polyrhythmic-glider/hardware-toolkit/examples-and-tests/esp32-e-lcd/neko-assistant/assets/README.txt

Neko asset partition
====================

The current release draws its monochrome cat and icons procedurally, so the
firmware remains usable even if this SPIFFS partition is erased. Future signed
sound packs and bitmap themes can be staged here without changing the OTA app
partition layout.
