polyrhythmic-glider/hardware-toolkit/examples-and-tests/esp32-e-lcd/NekoAssistant/cat-sprites-preview.png

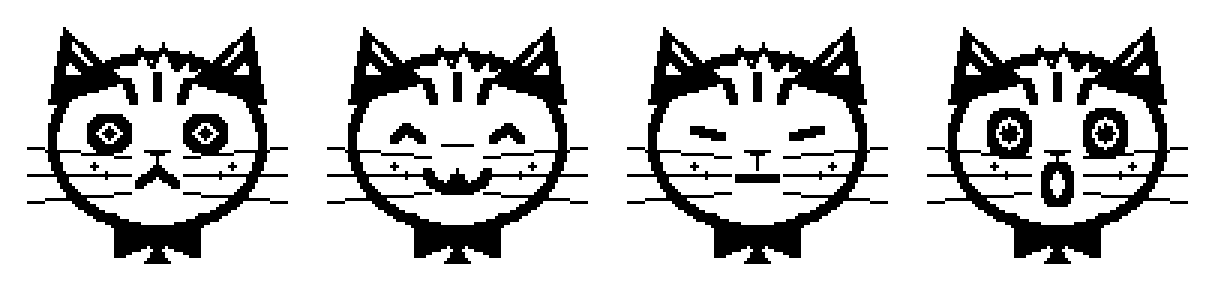
examples-and-tests/esp32-e-lcd/NekoAssistant/cat-sprites-preview.png
