polyrhythmic-glider/hardware-toolkit/TheSynthProject/MenuModel.h

#pragma once

#include <Arduino.h>
#include "ModulationModel.h"

// Azioni disponibili nel menu. Tenerle in un header evita che il preprocessore
// Arduino generi prototipi prima di conoscere il tipo MenuAction.
enum MenuAction {
  ACTION_VOICE_1_MENU,
  ACTION_VOICE_2_MENU,
  ACTION_VOICE_3_MENU,
  ACTION_FILTER_MENU,
  ACTION_OSC_ENABLED,
  ACTION_VOICE_WAVE,
  ACTION_OSC_LEVEL,
  ACTION_OSC_OCTAVE,
  ACTION_VOICE_TUNE,
  ACTION_VOICE_DETUNE,
  ACTION_OSC_PHASE,
  ACTION_OSC_PULSE_WIDTH,
  ACTION_VOICE_FOLD,
  ACTION_OSC_PAN,
  ACTION_OSC_KEY_TRACK,
  ACTION_OSC_MOD_AMOUNT,
  ACTION_VOICE_SCOPE,
  ACTION_PITCH,
  ACTION_LEVEL,
  ACTION_FILTER_POWER,
  ACTION_FILTER_TYPE,
  ACTION_FILTER_CUTOFF,
  ACTION_ADSR,
  ACTION_ATTACK,
  ACTION_DECAY,
  ACTION_SUSTAIN,
  ACTION_RELEASE,
  ACTION_SCOPE,
  ACTION_AUDIO_TEST,
  ACTION_SEQ_START,
  ACTION_SEQ_STOP,
  ACTION_SEQ_BPM,
  ACTION_SEQ_PATTERN_MENU,
  ACTION_SEQ_SETTINGS_MENU,
  ACTION_SEQ_VOICE,
  ACTION_SEQ_STEP,
  ACTION_SEQ_NOTE,
  ACTION_SEQ_LENGTH,
  ACTION_SEQ_PAGE,
  ACTION_SEQ_AUTO_SCROLL,
  ACTION_SEQ_STEP_ENABLE,
  ACTION_MIX_VOICE_1,
  ACTION_MIX_VOICE_2,
  ACTION_MIX_KICK,
  ACTION_KICK_PITCH,
  ACTION_KICK_DECAY,
  ACTION_KICK_SWEEP,
  ACTION_KICK_ATTACK,
  ACTION_KICK_DRIVE,
  ACTION_INPUTS,
  ACTION_DISPLAY_TEST,
  ACTION_SURFACE_MODE,
  ACTION_OLED_DEBUG,
  ACTION_MCP_DEBUG,
  ACTION_NEOKEY_DEBUG,
  ACTION_SERIAL_DEBUG,
  ACTION_CONNECTION_STATUS,
  ACTION_ABOUT,
  ACTION_DELAY_MIX,
  ACTION_DELAY_TIME,
  ACTION_DELAY_FEEDBACK,
  ACTION_REVERB_MIX,
  ACTION_REVERB_ROOM,
  ACTION_PRESET_SLOT,
  ACTION_PRESET_LOAD,
  ACTION_PRESET_SAVE,
  ACTION_SYNTH_VIEW,
  ACTION_TRANSPORT_MENU,
  ACTION_ENV_1_MENU,
  ACTION_ENV_2_MENU,
  ACTION_ENV_3_MENU,
  ACTION_ENV_DESTINATIONS_MENU,
  ACTION_MOD_DESTINATION_MENU,
  ACTION_MOD_ROUTE_ENABLED,
  ACTION_MOD_ROUTE_AMOUNT
};

struct MenuItem {
  const char* tag;
  const char* label;
  MenuAction action;
};

struct AreaChoice {
  const char* tag;
  const char* label;
  const uint8_t* items;
  int itemCount;
};

enum MenuItemIndex {
  ITEM_VOICE_1_MENU,
  ITEM_VOICE_2_MENU,
  ITEM_VOICE_3_MENU,
  ITEM_FILTER_MENU,
  ITEM_OSC_ENABLED,
  ITEM_VOICE_WAVE,
  ITEM_OSC_LEVEL,
  ITEM_OSC_OCTAVE,
  ITEM_VOICE_TUNE,
  ITEM_VOICE_DETUNE,
  ITEM_OSC_PHASE,
  ITEM_OSC_PULSE_WIDTH,
  ITEM_VOICE_FOLD,
  ITEM_OSC_PAN,
  ITEM_OSC_KEY_TRACK,
  ITEM_OSC_MOD_AMOUNT,
  ITEM_VOICE_SCOPE,
  ITEM_PITCH,
  ITEM_LEVEL,
  ITEM_ADSR,
  ITEM_ATTACK,
  ITEM_DECAY,
  ITEM_SCOPE,
  ITEM_INPUTS,
  ITEM_DISPLAY_TEST,
  ITEM_SURFACE_MODE,
  ITEM_OLED_DEBUG,
  ITEM_MCP_DEBUG,
  ITEM_NEOKEY_DEBUG,
  ITEM_SERIAL_DEBUG,
  ITEM_CONNECTION_STATUS,
  ITEM_ABOUT,
  ITEM_AUDIO_TEST,
  ITEM_SEQ_START,
  ITEM_SEQ_STOP,
  ITEM_SEQ_BPM,
  ITEM_SEQ_PATTERN_MENU,
  ITEM_SEQ_SETTINGS_MENU,
  ITEM_SEQ_VOICE,
  ITEM_SEQ_STEP,
  ITEM_SEQ_NOTE,
  ITEM_SEQ_LENGTH,
  ITEM_SEQ_PAGE,
  ITEM_SEQ_AUTO_SCROLL,
  ITEM_SEQ_STEP_ENABLE,
  ITEM_MIX_VOICE_1,
  ITEM_MIX_VOICE_2,
  ITEM_MIX_KICK,
  ITEM_KICK_PITCH,
  ITEM_KICK_DECAY,
  ITEM_KICK_SWEEP,
  ITEM_KICK_ATTACK,
  ITEM_KICK_DRIVE,
  ITEM_SUSTAIN,
  ITEM_RELEASE,
  ITEM_FILTER_POWER,
  ITEM_FILTER_TYPE,
  ITEM_FILTER_CUTOFF,
  ITEM_DELAY_MIX,
  ITEM_DELAY_TIME,
  ITEM_DELAY_FEEDBACK,
  ITEM_REVERB_MIX,
  ITEM_REVERB_ROOM,
  ITEM_PRESET_SLOT,
  ITEM_PRESET_LOAD,
  ITEM_PRESET_SAVE,
  ITEM_SYNTH_VIEW,
  ITEM_TRANSPORT_MENU,
  ITEM_ENV_1_MENU,
  ITEM_ENV_2_MENU,
  ITEM_ENV_3_MENU,
  ITEM_ENV_DESTINATIONS_MENU,
  ITEM_MOD_DEST_AMP_LEVEL,
  ITEM_MOD_DEST_FILTER_CUTOFF,
  ITEM_MOD_DEST_FILTER_RESONANCE,
  ITEM_MOD_DEST_OSC1_PITCH,
  ITEM_MOD_DEST_OSC2_PITCH,
  ITEM_MOD_DEST_OSC3_PITCH,
  ITEM_MOD_DEST_ALL_OSC_PITCH,
  ITEM_MOD_DEST_OSC1_LEVEL,
  ITEM_MOD_DEST_OSC2_LEVEL,
  ITEM_MOD_DEST_OSC3_LEVEL,
  ITEM_MOD_DEST_NOISE_LEVEL,
  ITEM_MOD_DEST_OSC1_PULSE_WIDTH,
  ITEM_MOD_DEST_OSC2_PULSE_WIDTH,
  ITEM_MOD_DEST_OSC3_PULSE_WIDTH,
  ITEM_MOD_DEST_OSC1_WAVEFOLD,
  ITEM_MOD_DEST_OSC2_WAVEFOLD,
  ITEM_MOD_DEST_OSC3_WAVEFOLD,
  ITEM_MOD_DEST_PAN,
  ITEM_MOD_DEST_DELAY_MIX,
  ITEM_MOD_DEST_REVERB_MIX,
  ITEM_MOD_ROUTE_ENABLED,
  ITEM_MOD_ROUTE_AMOUNT
};

enum MenuPage {
  MENU_PAGE_ROOT,
  MENU_PAGE_VOICE_1,
  MENU_PAGE_VOICE_2,
  MENU_PAGE_VOICE_3,
  MENU_PAGE_FILTER,
  MENU_PAGE_TRANSPORT,
  MENU_PAGE_SEQ_PATTERN,
  MENU_PAGE_SEQ_SETTINGS,
  MENU_PAGE_ENV_1,
  MENU_PAGE_ENV_2,
  MENU_PAGE_ENV_3,
  MENU_PAGE_ENV_DESTINATIONS,
  MENU_PAGE_MOD_DESTINATION
};

const MenuItem menuItems[] = {
  { "O1", "Oscillator 1", ACTION_VOICE_1_MENU },
  { "O2", "Oscillator 2", ACTION_VOICE_2_MENU },
  { "O3", "Oscillator 3", ACTION_VOICE_3_MENU },
  { "FLT", "Filter", ACTION_FILTER_MENU },
  { "PWR", "Oscillator Power", ACTION_OSC_ENABLED },
  { "WAVE", "Wave Type", ACTION_VOICE_WAVE },
  { "LEV", "Oscillator Level", ACTION_OSC_LEVEL },
  { "OCT", "Octave", ACTION_OSC_OCTAVE },
  { "TUNE", "Voice Tune", ACTION_VOICE_TUNE },
  { "DET", "Voice Detune", ACTION_VOICE_DETUNE },
  { "PHASE", "Phase Offset", ACTION_OSC_PHASE },
  { "PWM", "Pulse Width", ACTION_OSC_PULSE_WIDTH },
  { "FOLD", "Voice Fold", ACTION_VOICE_FOLD },
  { "PAN", "Oscillator Pan", ACTION_OSC_PAN },
  { "KEY", "Key Tracking", ACTION_OSC_KEY_TRACK },
  { "MOD", "Mod Input", ACTION_OSC_MOD_AMOUNT },
  { "SCP", "Voice Scope", ACTION_VOICE_SCOPE },
  { "TUNE", "Pitch", ACTION_PITCH },
  { "VOL", "Output Volume", ACTION_LEVEL },
  { "ADSR", "ADSR View", ACTION_ADSR },
  { "A", "Attack", ACTION_ATTACK },
  { "D", "Decay", ACTION_DECAY },
  { "SCP", "Wave Scope", ACTION_SCOPE },
  { "IN", "Inputs", ACTION_INPUTS },
  { "LCD", "Display", ACTION_DISPLAY_TEST },
  { "CTRL", "Control Surface", ACTION_SURFACE_MODE },
  { "OLED", "OLED Debug", ACTION_OLED_DEBUG },
  { "MCP", "MCP Debug", ACTION_MCP_DEBUG },
  { "KEY", "NeoKey Debug", ACTION_NEOKEY_DEBUG },
  { "SER", "Serial Diagnostics", ACTION_SERIAL_DEBUG },
  { "LINK", "Connection Status", ACTION_CONNECTION_STATUS },
  { "INFO", "About", ACTION_ABOUT },
  { "AUD", "Test Audio", ACTION_AUDIO_TEST },
  { "PLAY", "Start", ACTION_SEQ_START },
  { "STOP", "Stop", ACTION_SEQ_STOP },
  { "BPM", "Seq BPM", ACTION_SEQ_BPM },
  { "PAT", "Pattern", ACTION_SEQ_PATTERN_MENU },
  { "SET", "Settings", ACTION_SEQ_SETTINGS_MENU },
  { "TRK", "Seq Track", ACTION_SEQ_VOICE },
  { "STEP", "Seq Step", ACTION_SEQ_STEP },
  { "NOTE", "Seq Note", ACTION_SEQ_NOTE },
  { "LEN", "Seq Length", ACTION_SEQ_LENGTH },
  { "PAGE", "Seq Page", ACTION_SEQ_PAGE },
  { "AUTO", "Page Auto Scroll", ACTION_SEQ_AUTO_SCROLL },
  { "ON", "Step On", ACTION_SEQ_STEP_ENABLE },
  { "V1", "Voice 1 Volume", ACTION_MIX_VOICE_1 },
  { "V2", "Voice 2 Volume", ACTION_MIX_VOICE_2 },
  { "KICK", "Kick Level", ACTION_MIX_KICK },
  { "KTUN", "909 Tune", ACTION_KICK_PITCH },
  { "KDEC", "909 Decay", ACTION_KICK_DECAY },
  { "KSWP", "909 Sweep", ACTION_KICK_SWEEP },
  { "KATK", "909 Attack", ACTION_KICK_ATTACK },
  { "KDRV", "909 Drive", ACTION_KICK_DRIVE },
  { "S", "Sustain", ACTION_SUSTAIN },
  { "R", "Release", ACTION_RELEASE },
  { "PWR", "Filter Power", ACTION_FILTER_POWER },
  { "TYPE", "Filter Type", ACTION_FILTER_TYPE },
  { "CUT", "Filter Cutoff", ACTION_FILTER_CUTOFF },
  { "DLY", "Delay Mix", ACTION_DELAY_MIX },
  { "TIME", "Delay Time", ACTION_DELAY_TIME },
  { "FDBK", "Delay Feedback", ACTION_DELAY_FEEDBACK },
  { "REV", "Reverb Mix", ACTION_REVERB_MIX },
  { "ROOM", "Reverb Room", ACTION_REVERB_ROOM },
  { "SLOT", "Preset Slot", ACTION_PRESET_SLOT },
  { "LOAD", "Load Preset", ACTION_PRESET_LOAD },
  { "SAVE", "Save Preset", ACTION_PRESET_SAVE },
  { "VIEW", "Synth View", ACTION_SYNTH_VIEW },
  { "TRNS", "Transport", ACTION_TRANSPORT_MENU },
  { "ENV1", "ENV1", ACTION_ENV_1_MENU },
  { "ENV2", "ENV2", ACTION_ENV_2_MENU },
  { "ENV3", "ENV3", ACTION_ENV_3_MENU },
  { "DEST", "Destinations", ACTION_ENV_DESTINATIONS_MENU },
  { "AMP", "Amp Level", ACTION_MOD_DESTINATION_MENU },
  { "CUT", "Filter Cutoff", ACTION_MOD_DESTINATION_MENU },
  { "RES", "Filter Resonance", ACTION_MOD_DESTINATION_MENU },
  { "O1P", "Oscillator 1 Pitch", ACTION_MOD_DESTINATION_MENU },
  { "O2P", "Oscillator 2 Pitch", ACTION_MOD_DESTINATION_MENU },
  { "O3P", "Oscillator 3 Pitch", ACTION_MOD_DESTINATION_MENU },
  { "ALLP", "All Osc Pitch", ACTION_MOD_DESTINATION_MENU },
  { "O1L", "Oscillator 1 Level", ACTION_MOD_DESTINATION_MENU },
  { "O2L", "Oscillator 2 Level", ACTION_MOD_DESTINATION_MENU },
  { "O3L", "Oscillator 3 Level", ACTION_MOD_DESTINATION_MENU },
  { "NOISE", "Noise Level", ACTION_MOD_DESTINATION_MENU },
  { "O1PW", "Oscillator 1 PWM", ACTION_MOD_DESTINATION_MENU },
  { "O2PW", "Oscillator 2 PWM", ACTION_MOD_DESTINATION_MENU },
  { "O3PW", "Oscillator 3 PWM", ACTION_MOD_DESTINATION_MENU },
  { "O1F", "Oscillator 1 Fold", ACTION_MOD_DESTINATION_MENU },
  { "O2F", "Oscillator 2 Fold", ACTION_MOD_DESTINATION_MENU },
  { "O3F", "Oscillator 3 Fold", ACTION_MOD_DESTINATION_MENU },
  { "PAN", "Pan", ACTION_MOD_DESTINATION_MENU },
  { "DLY", "Delay Mix", ACTION_MOD_DESTINATION_MENU },
  { "REV", "Reverb Mix", ACTION_MOD_DESTINATION_MENU },
  { "ON", "Enabled", ACTION_MOD_ROUTE_ENABLED },
  { "AMT", "Amount", ACTION_MOD_ROUTE_AMOUNT }
};

const int MENU_ITEM_COUNT = sizeof(menuItems) / sizeof(menuItems[0]);
static_assert(MENU_ITEM_COUNT == ITEM_MOD_ROUTE_AMOUNT + 1, "Menu item index mismatch");
static_assert(ITEM_MOD_DEST_REVERB_MIX - ITEM_MOD_DEST_AMP_LEVEL + 1 == MOD_DESTINATION_COUNT,
              "Modulation destination menu mismatch");

// Indici dentro menuItems, separati per area o sottomenu.
const uint8_t MENU_WAVE_ITEMS[] = {
  ITEM_VOICE_1_MENU,
  ITEM_VOICE_2_MENU,
  ITEM_VOICE_3_MENU,
  ITEM_PITCH,
  ITEM_FILTER_MENU
};
const uint8_t MENU_WAVE_VOICE_ITEMS[] = {
  ITEM_OSC_ENABLED,
  ITEM_VOICE_WAVE,
  ITEM_OSC_LEVEL,
  ITEM_OSC_OCTAVE,
  ITEM_VOICE_TUNE,
  ITEM_VOICE_DETUNE,
  ITEM_OSC_PHASE,
  ITEM_OSC_PULSE_WIDTH,
  ITEM_VOICE_FOLD,
  ITEM_OSC_PAN,
  ITEM_OSC_KEY_TRACK,
  ITEM_OSC_MOD_AMOUNT,
  ITEM_VOICE_SCOPE
};
const uint8_t MENU_FILTER_ITEMS[] = {
  ITEM_FILTER_POWER,
  ITEM_FILTER_TYPE,
  ITEM_FILTER_CUTOFF
};
const uint8_t MENU_MIXER_ITEMS[] = {
  ITEM_MIX_VOICE_1,
  ITEM_MIX_VOICE_2,
  ITEM_DELAY_MIX,
  ITEM_DELAY_TIME,
  ITEM_DELAY_FEEDBACK,
  ITEM_REVERB_MIX,
  ITEM_REVERB_ROOM
};
const uint8_t MENU_KICK_ITEMS[] = {
  ITEM_MIX_KICK,
  ITEM_KICK_PITCH,
  ITEM_KICK_ATTACK,
  ITEM_KICK_DECAY,
  ITEM_KICK_SWEEP,
  ITEM_KICK_DRIVE
};
const uint8_t MENU_ENVELOPE_ITEMS[] = {
  ITEM_ENV_1_MENU,
  ITEM_ENV_2_MENU,
  ITEM_ENV_3_MENU
};
const uint8_t MENU_ENV_SOURCE_ITEMS[] = {
  ITEM_ATTACK,
  ITEM_DECAY,
  ITEM_SUSTAIN,
  ITEM_RELEASE,
  ITEM_ENV_DESTINATIONS_MENU
};
const uint8_t MENU_MOD_DESTINATION_ITEMS[] = {
  ITEM_MOD_DEST_AMP_LEVEL,
  ITEM_MOD_DEST_FILTER_CUTOFF,
  ITEM_MOD_DEST_FILTER_RESONANCE,
  ITEM_MOD_DEST_OSC1_PITCH,
  ITEM_MOD_DEST_OSC2_PITCH,
  ITEM_MOD_DEST_OSC3_PITCH,
  ITEM_MOD_DEST_ALL_OSC_PITCH,
  ITEM_MOD_DEST_OSC1_LEVEL,
  ITEM_MOD_DEST_OSC2_LEVEL,
  ITEM_MOD_DEST_OSC3_LEVEL,
  ITEM_MOD_DEST_NOISE_LEVEL,
  ITEM_MOD_DEST_OSC1_PULSE_WIDTH,
  ITEM_MOD_DEST_OSC2_PULSE_WIDTH,
  ITEM_MOD_DEST_OSC3_PULSE_WIDTH,
  ITEM_MOD_DEST_OSC1_WAVEFOLD,
  ITEM_MOD_DEST_OSC2_WAVEFOLD,
  ITEM_MOD_DEST_OSC3_WAVEFOLD,
  ITEM_MOD_DEST_PAN,
  ITEM_MOD_DEST_DELAY_MIX,
  ITEM_MOD_DEST_REVERB_MIX
};
const uint8_t MENU_MOD_ROUTE_ITEMS[] = {
  ITEM_MOD_ROUTE_ENABLED,
  ITEM_MOD_ROUTE_AMOUNT
};
const uint8_t MENU_SEQUENCER_ITEMS[] = {
  ITEM_SYNTH_VIEW,
  ITEM_TRANSPORT_MENU,
  ITEM_SEQ_PATTERN_MENU,
  ITEM_SEQ_SETTINGS_MENU
};
const uint8_t MENU_SEQ_PATTERN_ITEMS[] = {
  ITEM_SEQ_VOICE,
  ITEM_SEQ_STEP,
  ITEM_SEQ_NOTE,
  ITEM_SEQ_STEP_ENABLE
};
const uint8_t MENU_TRANSPORT_ITEMS[] = {
  ITEM_SEQ_START,
  ITEM_SEQ_STOP,
  ITEM_SEQ_BPM
};
const uint8_t MENU_SEQ_SETTINGS_ITEMS[] = {
  ITEM_SEQ_LENGTH,
  ITEM_SEQ_PAGE,
  ITEM_SEQ_AUTO_SCROLL
};
const uint8_t MENU_UTILITY_ITEMS[] = {
  ITEM_INPUTS,
  ITEM_DISPLAY_TEST,
  ITEM_SURFACE_MODE,
  ITEM_OLED_DEBUG,
  ITEM_MCP_DEBUG,
  ITEM_NEOKEY_DEBUG,
  ITEM_SERIAL_DEBUG,
  ITEM_CONNECTION_STATUS,
  ITEM_LEVEL,
  ITEM_AUDIO_TEST,
  ITEM_ABOUT,
  ITEM_PRESET_SLOT,
  ITEM_PRESET_LOAD,
  ITEM_PRESET_SAVE
};
const AreaChoice areaChoices[] = {
  { "WAVE", "Wave Engine", MENU_WAVE_ITEMS, sizeof(MENU_WAVE_ITEMS) / sizeof(MENU_WAVE_ITEMS[0]) },
  { "MIX", "Mixer", MENU_MIXER_ITEMS, sizeof(MENU_MIXER_ITEMS) / sizeof(MENU_MIXER_ITEMS[0]) },
  { "KICK", "Kick Voice", MENU_KICK_ITEMS, sizeof(MENU_KICK_ITEMS) / sizeof(MENU_KICK_ITEMS[0]) },
  { "ENV", "Envelope", MENU_ENVELOPE_ITEMS, sizeof(MENU_ENVELOPE_ITEMS) / sizeof(MENU_ENVELOPE_ITEMS[0]) },
  { "SEQ", "Sequencer", MENU_SEQUENCER_ITEMS, sizeof(MENU_SEQUENCER_ITEMS) / sizeof(MENU_SEQUENCER_ITEMS[0]) },
  { "UTIL", "Utility", MENU_UTILITY_ITEMS, sizeof(MENU_UTILITY_ITEMS) / sizeof(MENU_UTILITY_ITEMS[0]) }
};

const int TYPE_COUNT = sizeof(areaChoices) / sizeof(areaChoices[0]);
const int SEQUENCER_AREA_INDEX = 4;
