polyrhythmic-glider/hardware-toolkit/TheSynthProject/MixerModel.h

#pragma once

#include "MenuModel.h"

// Converte un'azione mixer nell'indice della voce corrispondente.
inline int getMixerWaveIndex(int action) {
  switch (action) {
    case ACTION_MIX_VOICE_1:
      return 0;

    case ACTION_MIX_VOICE_2:
      return 1;

    default:
      return -1;
  }
}

// Checksum compatto per invalidare la UI quando cambia un gruppo di fader.
inline int getLevelChecksum(const int levels[], int count) {
  int checksum = 0;

  for (int i = 0; i < count; i++) {
    checksum = checksum * 31 + levels[i];
  }

  return checksum;
}
