polyrhythmic-glider/hardware-toolkit/TheSynthProject/UiWidgets.h

#pragma once

extern uint16_t neokeyLastRawKeys;
extern uint16_t neokeyStableKeys;
extern uint8_t neokeyLastBoardRawKeys[];

uint16_t getSequencerTrackColor(int track);

void drawHeader(const char* title) {
  tft.fillRect(0, 0, SCREEN_W, 20, COL_HEADER);
  tft.fillTriangle(0, 0, 18, 0, 0, 20, COL_VIOLET);
  tft.drawFastHLine(0, 19, SCREEN_W, COL_CORAL);

  tft.setTextSize(1);
  tft.setTextColor(COL_INK);
  tft.setCursor(7, 6);
  tft.print(title);
}

void drawStageBackdrop() {
  tft.fillScreen(COL_BG);

  for (int y = 25; y < SCREEN_H; y += 12) {
    tft.drawFastHLine(0, y, SCREEN_W, COL_LINE);
  }

  for (int i = 0; i < 10; i++) {
    int x = 13 + i * 15;
    int y = 31 + (i * 17) % 72;
    tft.drawPixel(x, y, COL_MUTED);
    tft.drawPixel(x + 1, y, COL_MUTED);
  }
}

void drawParamIcon(int itemIndex, int cx, int cy, uint16_t color) {
  MenuAction action = menuItems[itemIndex].action;

  switch (action) {
    case ACTION_VOICE_1_MENU:
      drawWaveShapePreviewForParams(cx - 8, cy - 5, 16, 10, waveVoiceShape[0], (float)waveVoiceFold[0], 0.0f, color);
      tft.drawPixel(cx + 9, cy, COL_GOLD);
      break;

    case ACTION_VOICE_2_MENU:
      drawWaveShapePreviewForParams(cx - 8, cy - 5, 16, 10, waveVoiceShape[1], (float)waveVoiceFold[1], 0.0f, color);
      tft.drawPixel(cx + 9, cy, COL_GOLD);
      break;

    case ACTION_FILTER_MENU:
      tft.drawFastHLine(cx - 8, cy + 5, 16, rgb565(62, 68, 82));
      tft.drawLine(cx - 8, cy - 5, cx, cy - 1, color);
      tft.drawLine(cx, cy - 1, cx + 8, cy + 5, color);
      tft.drawPixel(cx + 10, cy, COL_GOLD);
      break;

    case ACTION_VOICE_WAVE:
    {
      int voice = getCurrentWaveVoiceIndex();
      drawWaveShapePreviewForParams(cx - 8, cy - 5, 16, 10, waveVoiceShape[voice], (float)waveVoiceFold[voice], 0.0f, color);
      tft.drawPixel(cx + 9, cy, COL_GOLD);
      break;
    }

    case ACTION_VOICE_TUNE:
      tft.drawFastVLine(cx, cy - 7, 15, color);
      tft.drawLine(cx - 6, cy - 5, cx, cy - 1, color);
      tft.drawLine(cx + 6, cy - 5, cx, cy - 1, color);
      tft.fillCircle(cx, cy + 5, 2, COL_GOLD);
      break;

    case ACTION_VOICE_FOLD:
      tft.drawLine(cx - 8, cy + 4, cx - 3, cy - 5, color);
      tft.drawLine(cx - 3, cy - 5, cx + 2, cy + 5, color);
      tft.drawLine(cx + 2, cy + 5, cx + 7, cy - 4, color);
      tft.fillCircle(cx + 8, cy - 4, 1, COL_GOLD);
      break;

    case ACTION_VOICE_DETUNE:
      tft.drawCircle(cx, cy, 6, color);
      tft.drawLine(cx, cy, cx + 6, cy - 1, color);
      tft.fillCircle(cx + 6, cy - 1, 2, COL_GOLD);
      break;

    case ACTION_VOICE_SCOPE:
    {
      int voice = getCurrentWaveVoiceIndex();
      drawWaveShapePreviewForParams(cx - 8, cy - 5, 16, 10, waveVoiceShape[voice], (float)waveVoiceFold[voice], 0.0f, color);
      tft.drawFastHLine(cx - 8, cy + 7, 16, COL_GOLD);
      break;
    }

    case ACTION_PITCH:
      tft.drawFastVLine(cx, cy - 6, 13, color);
      tft.drawLine(cx - 5, cy - 5, cx, cy - 1, color);
      tft.drawLine(cx + 5, cy - 5, cx, cy - 1, color);
      tft.fillCircle(cx, cy + 5, 2, color);
      break;

    case ACTION_LEVEL:
      for (int i = 0; i < 4; i++) {
        int h = 4 + i * 3;
        tft.fillRect(cx - 8 + i * 5, cy + 6 - h, 3, h, color);
      }
      break;

    case ACTION_FILTER_POWER:
      tft.drawCircle(cx, cy, 8, color);
      tft.drawFastVLine(cx, cy - 8, 8, color);
      tft.drawFastHLine(cx - 6, cy + 5, 12, filterEnabled ? COL_GOLD : rgb565(62, 68, 82));
      break;

    case ACTION_FILTER_TYPE:
      tft.drawFastHLine(cx - 8, cy + 5, 16, rgb565(62, 68, 82));
      tft.drawLine(cx - 8, cy - 5, cx - 1, cy - 2, color);
      tft.drawLine(cx - 1, cy - 2, cx + 3, cy + 3, color);
      tft.drawLine(cx + 3, cy + 3, cx + 8, cy + 5, color);
      break;

    case ACTION_FILTER_CUTOFF:
      tft.drawFastHLine(cx - 8, cy + 5, 16, color);
      tft.drawFastVLine(cx, cy - 6, 12, COL_GOLD);
      tft.drawLine(cx - 8, cy - 2, cx, cy - 2, color);
      tft.drawLine(cx, cy - 2, cx + 8, cy + 4, color);
      break;

    case ACTION_ADSR:
    case ACTION_ENV_1_MENU:
    case ACTION_ENV_2_MENU:
      tft.drawLine(cx - 8, cy + 5, cx - 3, cy - 5, color);
      tft.drawLine(cx - 3, cy - 5, cx + 2, cy, color);
      tft.drawLine(cx + 2, cy, cx + 6, cy, color);
      tft.drawLine(cx + 6, cy, cx + 8, cy + 5, color);
      break;

    case ACTION_ENV_DESTINATIONS_MENU:
    case ACTION_MOD_DESTINATION_MENU:
      tft.fillCircle(cx - 7, cy, 2, COL_GOLD);
      tft.fillCircle(cx + 7, cy - 5, 2, color);
      tft.fillCircle(cx + 7, cy + 5, 2, color);
      tft.drawLine(cx - 5, cy, cx + 5, cy - 5, color);
      tft.drawLine(cx - 5, cy, cx + 5, cy + 5, color);
      break;

    case ACTION_MOD_ROUTE_ENABLED:
      tft.drawCircle(cx, cy, 8, color);
      tft.drawFastVLine(cx, cy - 8, 8, COL_GOLD);
      break;

    case ACTION_MOD_ROUTE_AMOUNT:
      tft.drawFastHLine(cx - 8, cy, 17, color);
      tft.drawFastVLine(cx, cy - 7, 15, COL_GOLD);
      tft.fillCircle(cx + 6, cy, 2, color);
      break;

    case ACTION_ATTACK:
      tft.drawLine(cx - 8, cy + 5, cx + 7, cy - 5, color);
      tft.drawFastHLine(cx - 8, cy + 5, 16, color);
      tft.fillTriangle(cx + 7, cy - 5, cx + 3, cy - 4, cx + 5, cy - 1, color);
      break;

    case ACTION_DECAY:
      tft.drawLine(cx - 8, cy - 5, cx + 7, cy + 5, color);
      tft.drawFastHLine(cx - 8, cy + 5, 16, color);
      tft.fillTriangle(cx + 7, cy + 5, cx + 3, cy + 4, cx + 5, cy + 1, color);
      break;

    case ACTION_SUSTAIN:
      tft.drawLine(cx - 8, cy - 4, cx - 2, cy, color);
      tft.drawFastHLine(cx - 2, cy, 10, color);
      tft.drawFastHLine(cx - 8, cy + 5, 16, rgb565(62, 68, 82));
      tft.fillCircle(cx + 7, cy, 2, color);
      break;

    case ACTION_RELEASE:
      tft.drawFastHLine(cx - 8, cy + 5, 16, rgb565(62, 68, 82));
      tft.drawLine(cx - 8, cy - 5, cx + 7, cy + 5, color);
      tft.fillTriangle(cx + 7, cy + 5, cx + 3, cy + 4, cx + 5, cy + 1, color);
      break;

    case ACTION_SCOPE:
      drawWavePreview(cx - 8, cy - 5, 16, 10, color);
      break;

    case ACTION_AUDIO_TEST:
      drawWavePreview(cx - 8, cy - 5, 16, 10, color);
      tft.drawFastVLine(cx + 9, cy - 7, 14, COL_GOLD);
      break;

    case ACTION_TRANSPORT_MENU:
      tft.drawCircle(cx, cy, 9, color);
      tft.fillTriangle(cx - 4, cy - 5, cx - 4, cy + 5, cx + 3, cy, color);
      tft.fillRect(cx + 4, cy - 4, 3, 8, COL_GOLD);
      break;

    case ACTION_SEQ_START:
      tft.fillTriangle(cx - 5, cy - 7, cx - 5, cy + 7, cx + 7, cy, color);
      tft.drawCircle(cx, cy, 9, transportRunning ? COL_GOLD : rgb565(62, 68, 82));
      break;

    case ACTION_SEQ_STOP:
      tft.fillRect(cx - 6, cy - 6, 12, 12, color);
      tft.drawCircle(cx, cy, 9, !transportRunning ? COL_GOLD : rgb565(62, 68, 82));
      break;

    case ACTION_SYNTH_VIEW:
      tft.drawRect(cx - 9, cy - 7, 18, 14, color);
      tft.drawFastHLine(cx - 7, cy + 3, 14, COL_GOLD);
      tft.fillCircle(cx - 4, cy - 1, 2, color);
      tft.fillCircle(cx + 4, cy - 1, 2, COL_SKY);
      break;

    case ACTION_SEQ_PATTERN_MENU:
      for (int row = 0; row < 3; row++) {
        uint16_t laneColor = getSequencerTrackColor(row);
        tft.drawFastHLine(cx - 8, cy - 6 + row * 6, 17, laneColor);
        tft.fillCircle(cx - 4 + row * 4, cy - 6 + row * 6, 2, laneColor);
      }
      break;

    case ACTION_SEQ_SETTINGS_MENU:
      tft.drawCircle(cx, cy, 7, color);
      tft.fillCircle(cx, cy, 2, COL_GOLD);
      tft.drawFastVLine(cx, cy - 10, 4, color);
      tft.drawFastVLine(cx, cy + 7, 4, color);
      tft.drawFastHLine(cx - 10, cy, 4, color);
      tft.drawFastHLine(cx + 7, cy, 4, color);
      break;

    case ACTION_SEQ_BPM:
      tft.drawCircle(cx, cy, 8, color);
      tft.drawLine(cx, cy, cx + 5, cy - 5, color);
      tft.fillCircle(cx, cy, 2, COL_GOLD);
      break;

    case ACTION_SEQ_VOICE:
      tft.drawRect(cx - 8, cy - 6, 16, 12, color);
      tft.drawFastHLine(cx - 8, cy, 16, COL_LINE);
      tft.fillRect(cx - 6, cy - 4 + getActiveSequencerVoice() * 6, 12, 4, COL_GOLD);
      break;

    case ACTION_SEQ_STEP:
      for (int i = 0; i < 4; i++) {
        tft.drawRect(cx - 8 + i * 5, cy - 5, 4, 10, color);
      }
      tft.fillRect(cx - 8, cy - 5, 4, 10, COL_GOLD);
      break;

    case ACTION_SEQ_NOTE:
      tft.drawFastVLine(cx - 5, cy - 7, 14, color);
      tft.drawFastHLine(cx - 5, cy - 7, 8, color);
      tft.drawFastHLine(cx - 5, cy - 1, 8, color);
      tft.fillCircle(cx + 5, cy + 5, 3, COL_GOLD);
      break;

    case ACTION_SEQ_LENGTH:
    {
      int filledSegments = (sequencerLength * 4 + SEQUENCER_STEP_COUNT - 1) / SEQUENCER_STEP_COUNT;
      for (int i = 0; i < 4; i++) {
        tft.drawRect(cx - 8 + i * 5, cy - 5, 4, 10, i < filledSegments ? color : rgb565(62, 68, 82));
      }
      break;
    }

    case ACTION_SEQ_PAGE:
      for (int i = 0; i < SEQUENCER_PAGE_COUNT; i++) {
        if (i == getSequencerPage()) tft.fillCircle(cx - 7 + i * 5, cy, 2, COL_GOLD);
        else tft.drawCircle(cx - 7 + i * 5, cy, 2, color);
      }
      break;

    case ACTION_SEQ_AUTO_SCROLL:
      tft.drawLine(cx - 8, cy - 3, cx + 7, cy - 3, color);
      tft.fillTriangle(cx + 7, cy - 3, cx + 3, cy - 6, cx + 3, cy, color);
      tft.drawLine(cx + 8, cy + 4, cx - 7, cy + 4, COL_GOLD);
      tft.fillTriangle(cx - 7, cy + 4, cx - 3, cy + 1, cx - 3, cy + 7, COL_GOLD);
      break;

    case ACTION_SEQ_STEP_ENABLE:
      tft.drawCircle(cx, cy, 8, color);
      if (isSelectedSequencerStepEnabled()) {
        tft.fillCircle(cx, cy, 5, COL_GOLD);
      } else {
        tft.drawLine(cx - 6, cy + 6, cx + 6, cy - 6, COL_CORAL);
      }
      break;

    case ACTION_MIX_VOICE_1:
      drawWaveShapePreviewForParams(cx - 8, cy - 5, 16, 10, voiceOscillators[0].waveVoiceShape[0], (float)voiceOscillators[0].waveVoiceFold[0], 0.0f, color);
      tft.drawFastHLine(cx - 8, cy + 7, map(voiceOscillators[0].masterLevelPercent, 0, 100, 0, 16), COL_GOLD);
      break;

    case ACTION_MIX_VOICE_2:
      drawWaveShapePreviewForParams(cx - 8, cy - 5, 16, 10, voiceOscillators[1].waveVoiceShape[0], (float)voiceOscillators[1].waveVoiceFold[0], 0.0f, color);
      tft.drawFastHLine(cx - 8, cy + 7, map(voiceOscillators[1].masterLevelPercent, 0, 100, 0, 16), COL_GOLD);
      break;

    case ACTION_MIX_KICK:
      tft.drawCircle(cx, cy, 8, color);
      tft.fillCircle(cx, cy, 4, COL_GOLD);
      tft.drawFastHLine(cx - 10, cy + 8, 20, color);
      break;

    case ACTION_KICK_PITCH:
      tft.drawCircle(cx, cy, 7, color);
      tft.drawLine(cx, cy, cx + 4, cy - 5, COL_GOLD);
      tft.drawFastHLine(cx - 8, cy + 8, 16, color);
      break;

    case ACTION_KICK_DECAY:
      tft.drawLine(cx - 8, cy - 5, cx + 7, cy + 5, color);
      tft.drawFastHLine(cx - 8, cy + 5, 16, COL_GOLD);
      break;

    case ACTION_KICK_SWEEP:
      tft.drawLine(cx - 8, cy + 5, cx - 2, cy - 3, color);
      tft.drawLine(cx - 2, cy - 3, cx + 8, cy - 5, COL_GOLD);
      break;

    case ACTION_KICK_ATTACK:
      tft.drawFastVLine(cx - 4, cy - 7, 14, COL_GOLD);
      tft.drawLine(cx - 4, cy - 7, cx + 8, cy + 5, color);
      break;

    case ACTION_KICK_DRIVE:
      tft.drawRect(cx - 8, cy - 6, 16, 12, color);
      tft.drawLine(cx - 7, cy + 4, cx - 2, cy - 4, COL_GOLD);
      tft.drawLine(cx - 2, cy - 4, cx + 3, cy + 4, COL_GOLD);
      tft.drawLine(cx + 3, cy + 4, cx + 7, cy - 3, COL_GOLD);
      break;

    case ACTION_INPUTS:
      tft.drawCircle(cx - 4, cy - 2, 3, color);
      tft.drawCircle(cx + 5, cy + 3, 3, color);
      tft.drawLine(cx - 1, cy - 1, cx + 2, cy + 2, color);
      break;

    case ACTION_DISPLAY_TEST:
      tft.drawRect(cx - 7, cy - 5, 14, 10, color);
      tft.drawFastHLine(cx - 4, cy + 7, 8, color);
      break;

    case ACTION_SURFACE_MODE:
      for (int i = 0; i < 4; i++) {
        int bx = cx - 9 + i * 5;
        tft.drawRect(bx, cy - 5, 4, 8, color);
        tft.drawCircle(bx + 2, cy + 7, 1, i == 3 ? COL_GOLD : color);
      }
      break;

    case ACTION_OLED_DEBUG:
      tft.drawRect(cx - 9, cy - 7, 18, 12, color);
      tft.drawFastHLine(cx - 6, cy + 8, 12, color);
      for (int i = 0; i < 4; i++) {
        tft.drawPixel(cx - 6 + i * 4, cy - 3, i == 3 ? COL_GOLD : color);
        tft.drawPixel(cx - 6 + i * 4, cy, i == 3 ? COL_GOLD : color);
      }
      break;

    case ACTION_MCP_DEBUG:
      tft.drawRect(cx - 7, cy - 7, 14, 14, color);
      for (int i = -5; i <= 5; i += 5) {
        tft.drawFastHLine(cx - 10, cy + i, 3, color);
        tft.drawFastHLine(cx + 8, cy + i, 3, color);
      }
      tft.fillCircle(cx, cy, 2, COL_GOLD);
      break;

    case ACTION_NEOKEY_DEBUG:
      for (int i = 0; i < 4; i++) {
        int keyX = cx - 9 + i * 5;
        tft.drawRect(keyX, cy - 5, 4, 10, i == 0 ? COL_GOLD : color);
      }
      break;

    case ACTION_SERIAL_DEBUG:
      tft.drawRect(cx - 9, cy - 7, 18, 14, color);
      tft.drawLine(cx - 6, cy - 3, cx - 3, cy, COL_GOLD);
      tft.drawLine(cx - 3, cy, cx - 6, cy + 3, COL_GOLD);
      tft.drawFastHLine(cx, cy + 3, 5, color);
      break;

    case ACTION_CONNECTION_STATUS:
      tft.drawCircle(cx - 5, cy, 3, COL_NOTE);
      tft.drawCircle(cx + 5, cy, 3, color);
      tft.drawLine(cx - 2, cy, cx + 2, cy, COL_GOLD);
      tft.drawPixel(cx, cy - 5, COL_GOLD);
      tft.drawPixel(cx, cy + 5, COL_GOLD);
      break;

    case ACTION_ABOUT:
      tft.drawCircle(cx, cy, 6, color);
      tft.setTextColor(color);
      tft.setTextSize(1);
      tft.setCursor(cx - 2, cy - 4);
      tft.print("i");
      break;

    default:
      break;
  }
}

void drawGrooveBar(int x, int y, int width, int height, int fillWidth, uint16_t color) {
  int innerW = width - 2;
  int clampedFill = clampInt(fillWidth, 0, innerW);

  tft.fillRect(x, y, width, height, COL_PANEL);
  tft.drawRect(x, y, width, height, COL_LINE);

  for (int i = 1; i < 8; i++) {
    int tickX = x + 1 + (innerW * i) / 8;
    tft.drawFastVLine(tickX, y + 1, height - 2, COL_LINE);
  }

  if (clampedFill > 0) {
    tft.fillRect(x + 1, y + 1, clampedFill, height - 2, color);
  }

  int needleX = x + 1 + clampedFill;
  if (needleX >= x + width) needleX = x + width - 2;

  tft.drawFastVLine(needleX, y - 2, height + 4, COL_INK);
}

void drawPanelFrame(int x, int y, int width, int height, uint16_t accent) {
  tft.fillRect(x, y, width, height, COL_PANEL);
  tft.drawRect(x, y, width, height, COL_LINE);
  tft.drawFastHLine(x, y, width, accent);
}

void drawValueReadout(const char* value, const char* tag, uint16_t accent) {
  tft.setTextSize(2);
  tft.setTextColor(accent);
  tft.setCursor(10, 56);
  tft.print(value);

  tft.setTextSize(1);
  tft.setTextColor(COL_MUTED);
  tft.setCursor(108, 59);
  tft.print(tag);
}

void drawEffectEdit(MenuAction action, uint16_t accent) {
  int value = 0;
  int maximum = 100;
  const char* left = "DRY";
  const char* right = "WET";

  if (action == ACTION_DELAY_MIX) value = delayMix;
  if (action == ACTION_DELAY_TIME) {
    value = delayTimeMs;
    maximum = DELAY_MAX_MS;
    left = "SHORT";
    right = "LONG";
  }
  if (action == ACTION_DELAY_FEEDBACK) {
    value = delayFeedback;
    left = "ONE";
    right = "ECHO";
  }
  if (action == ACTION_REVERB_MIX) value = reverbMix;
  if (action == ACTION_REVERB_ROOM) {
    value = reverbRoom;
    left = "TIGHT";
    right = "HALL";
  }

  drawValueReadout(getValueText(getMenuItemIndex(selectedItem)), menuItems[getMenuItemIndex(selectedItem)].tag, accent);
  drawPanelFrame(10, 78, 140, 35, accent);
  drawGrooveBar(20, 91, 120, 10, map(value, 0, maximum, 0, 118), accent);
  tft.setTextSize(1);
  tft.setTextColor(COL_MUTED);
  tft.setCursor(10, 119);
  tft.print(left);
  printRight(right, 150, 119, 1, COL_MUTED);
}

void drawPresetEdit(MenuAction action, uint16_t accent) {
  char slotText[8];
  snprintf(slotText, sizeof(slotText), "P%d", presetSlot);
  drawValueReadout(slotText, "PRESET", accent);
  drawPanelFrame(10, 78, 140, 42, accent);
  tft.setTextSize(2);
  tft.setTextColor(action == ACTION_PRESET_SLOT ? accent : presetOperationOk ? COL_NOTE : COL_CORAL);
  tft.setCursor(20, 88);
  tft.print(action == ACTION_PRESET_SLOT ? "SELECT" : presetOperationText);
  tft.setTextSize(1);
  tft.setTextColor(COL_MUTED);
  tft.setCursor(14, 112);
  tft.print(action == ACTION_PRESET_SLOT ? "1..8 in flash" : "press to return");
}

void drawScopeGrid(int x, int y, int width, int height) {
  for (int i = 1; i < 4; i++) {
    int gx = x + (width * i) / 4;
    tft.drawFastVLine(gx, y + 1, height - 2, rgb565(24, 29, 43));
  }

  for (int i = 1; i < 3; i++) {
    int gy = y + (height * i) / 3;
    tft.drawFastHLine(x + 1, gy, width - 2, rgb565(24, 29, 43));
  }
}

void drawOscilloscopeTrace(int x, int y, int width, int height, uint16_t accent, bool useLevel) {
  float amplitude = useLevel ? volume / 100.0f : 1.0f;
  int centerY = y + height / 2;
  int prevY = centerY;

  for (int i = 0; i < width; i++) {
    float phase = (float)i / (float)(width - 1) * 2.0f;
    float sample = getOscillatorSample(phase) * amplitude;
    int nextY = centerY - (int)(sample * (height / 2 - 3));

    if (i > 0) {
      tft.drawLine(x + i - 1, prevY, x + i, nextY, accent);
    }

    prevY = nextY;
  }
}

const char* getWaveformShortName(int shape) {
  switch (shape) {
    case 0: return "SIN";
    case 1: return "SQR";
    case 2: return "TRI";
    case 3: return "SAW";
    case 4: return "RMP";
    case 5: return "PLS";
    case 6: return "SUB";
    case 7: return "ORG";
    case 8: return "EVN";
    case 9: return "ODD";
    case 10: return "SUP";
    case 11: return "PWM";
    case 12: return "STP";
    case 13: return "CLP";
    case 14: return "NOI";
    case 15: return "FRM";
    default: return "---";
  }
}

void drawWaveShapeTabs(int selectedShape, int y, uint16_t accent) {
  int firstShape = selectedShape - 1;
  int maxFirst = WAVE_SHAPE_COUNT - 4;
  if (maxFirst < 0) maxFirst = 0;
  firstShape = clampInt(firstShape, 0, maxFirst);

  for (int i = 0; i < 4; i++) {
    int shape = firstShape + i;
    if (shape >= WAVE_SHAPE_COUNT) break;

    int x = 10 + i * 37;
    bool active = shape == selectedShape;

    if (active) {
      tft.fillRect(x - 2, y - 2, 32, 12, accent);
      tft.setTextColor(COL_BG);
    } else {
      tft.drawRect(x - 2, y - 2, 32, 12, COL_LINE);
      tft.setTextColor(COL_MUTED);
    }

    tft.setTextSize(1);
    tft.setCursor(x + 1, y + 1);
    tft.print(getWaveformShortName(shape));
  }
}

void drawEnvelopeCurve(bool attackMode, uint16_t accent) {
  int x = 12;
  int y = 79;
  int width = 136;
  int height = 30;
  int baseY = y + height - 3;
  int peakY = y + 3;
  int totalMs = attack + decay;
  if (totalMs < 1) totalMs = 1;
  int attackX = x + map(attack, 0, totalMs, 2, width - 4);

  drawPanelFrame(10, 76, 140, 38, accent);

  tft.drawFastHLine(x, baseY, width, rgb565(34, 40, 53));
  tft.drawFastVLine(x, peakY, height, rgb565(34, 40, 53));
  tft.drawLine(x + 2, baseY, attackX, peakY, attackMode ? accent : COL_SKY);
  tft.drawLine(attackX, peakY, x + width - 4, baseY, attackMode ? COL_SKY : accent);

  if (attackMode) {
    tft.fillCircle(attackX, peakY, 2, COL_GOLD);
  } else {
    tft.fillCircle(x + width - 4, baseY, 2, COL_GOLD);
  }

  tft.setTextSize(1);
  tft.setTextColor(COL_MUTED);
  tft.setCursor(14, 118);
  tft.print("A");
  tft.print(attack);
  tft.print(" D");
  tft.print(decay);
}

void drawAdsrCurve(uint16_t accent) {
  const AdsrParameters& envelope = getActiveEnvelopeParameters();
  int x = 12;
  int y = 76;
  int width = 136;
  int height = 42;
  int baseY = y + height - 5;
  int peakY = y + 5;
  int sustainY = baseY - map(envelope.sustainPercent, 0, 100, 0, height - 10);

  int attackX = x + map(envelope.attackMs, 0, 500, 14, 42);
  int decayX = attackX + map(envelope.decayMs, 0, 2000, 18, 42);
  int sustainX = decayX + 30;
  int releaseX = x + width - 6;

  if (decayX > x + 92) decayX = x + 92;
  if (sustainX > x + 116) sustainX = x + 116;

  drawPanelFrame(10, 73, 140, 47, accent);

  tft.drawFastHLine(x, baseY, width, rgb565(34, 40, 53));
  tft.drawFastVLine(x, peakY, height - 8, rgb565(34, 40, 53));

  MenuAction focus = getSelectedAction();
  bool overview = focus == ACTION_ADSR;
  uint16_t dim = rgb565(56, 62, 76);
  uint16_t attackColor = overview || focus == ACTION_ATTACK ? accent : dim;
  uint16_t decayColor = overview ? COL_SKY : focus == ACTION_DECAY ? accent : dim;
  uint16_t sustainColor = overview ? COL_GOLD : focus == ACTION_SUSTAIN ? accent : dim;
  uint16_t releaseColor = overview ? COL_CORAL : focus == ACTION_RELEASE ? accent : dim;

  tft.drawLine(x + 2, baseY, attackX, peakY, attackColor);
  tft.drawLine(attackX, peakY, decayX, sustainY, decayColor);
  tft.drawLine(decayX, sustainY, sustainX, sustainY, sustainColor);
  tft.drawLine(sustainX, sustainY, releaseX, baseY, releaseColor);

  tft.fillCircle(attackX, peakY, 2, attackColor);
  tft.fillCircle(decayX, sustainY, 2, decayColor);
  tft.fillCircle(sustainX, sustainY, 2, sustainColor);

  tft.setTextSize(1);
  char label[12];

  tft.setTextColor(overview || focus == ACTION_ATTACK ? attackColor : COL_MUTED);
  snprintf(label, sizeof(label), "A%d", envelope.attackMs);
  tft.setCursor(12, 122);
  tft.print(label);

  tft.setTextColor(overview || focus == ACTION_DECAY ? decayColor : COL_MUTED);
  snprintf(label, sizeof(label), "D%d", envelope.decayMs);
  tft.setCursor(44, 122);
  tft.print(label);

  tft.setTextColor(overview || focus == ACTION_SUSTAIN ? sustainColor : COL_MUTED);
  snprintf(label, sizeof(label), "S%d", envelope.sustainPercent);
  tft.setCursor(84, 122);
  tft.print(label);

  snprintf(label, sizeof(label), "R%d", envelope.releaseMs);
  printRight(label, 150, 122, 1, overview || focus == ACTION_RELEASE ? releaseColor : COL_MUTED);
}

void drawPitchEdit(uint16_t accent) {
  char pitchLabel[12];
  getPitchLabel(pitchLabel, sizeof(pitchLabel));

  drawValueReadout(getValueText(getMenuItemIndex(selectedItem)), "PITCH", accent);
  printRight(pitchLabel, 150, 67, 1, COL_INK);
  drawPanelFrame(10, 74, 140, 41, accent);
  drawScopeGrid(10, 74, 140, 41);
  drawOscilloscopeTrace(14, 78, 132, 33, accent, false);
  printRight("native osc", 149, 120, 1, COL_MUTED);
}

void drawLevelEdit(uint16_t accent) {
  char dbText[12];
  snprintf(dbText, sizeof(dbText), "%ddB", getRmsDbFs());

  drawValueReadout(getValueText(getMenuItemIndex(selectedItem)), "OUTPUT", accent);
  printRight(dbText, 150, 67, 1, COL_INK);

  int leftFill = map(volume, 0, 100, 0, 62);
  int rightFill = map(clampInt((int)(getOscillatorRms() * 100.0f), 0, 100), 0, 100, 0, 62);

  drawGrooveBar(10, 78, 66, 9, leftFill, accent);
  drawGrooveBar(84, 78, 66, 9, rightFill, COL_SKY);

  tft.setTextSize(1);
  tft.setTextColor(COL_MUTED);
  tft.setCursor(10, 94);
  tft.print("PEAK");
  tft.setCursor(84, 94);
  tft.print("RMS");

  drawPanelFrame(10, 103, 140, 22, accent);
  drawGrooveBar(14, 109, 132, 9, map(volume, 0, 100, 0, 130), accent);
}

uint16_t getMixerVoiceColor(int voiceIndex, uint16_t accent);

void drawVoiceOscilloscopeTrace(int x, int y, int width, int height, int voice, uint16_t accent) {
  int centerY = y + height / 2;
  int prevY = centerY;

  for (int i = 0; i < width; i++) {
    float phase = (float)i / (float)(width - 1) * 2.0f;
    float sample = getOscillatorSampleForParams(phase, waveVoiceShape[voice], (float)waveVoiceFold[voice], 0.0f);
    int nextY = centerY - (int)(sample * (height / 2 - 3));

    if (i > 0) {
      tft.drawLine(x + i - 1, prevY, x + i, nextY, accent);
    }

    prevY = nextY;
  }
}

void drawVoiceScopePanel(int voice, uint16_t accent) {
  drawPanelFrame(10, 74, 140, 34, accent);
  drawScopeGrid(10, 74, 140, 34);
  drawVoiceOscilloscopeTrace(14, 78, 132, 26, voice, accent);
}

void drawVoiceWaveEdit(uint16_t accent) {
  int voice = getCurrentWaveVoiceIndex();
  int shape = waveVoiceShape[voice];

  drawValueReadout(waveformNames[shape], "WAVE", accent);
  char voiceText[6];
  snprintf(voiceText, sizeof(voiceText), "V%d", voice + 1);
  printRight(voiceText, 150, 67, 1, getMixerVoiceColor(voice, accent));
  drawVoiceScopePanel(voice, accent);
  drawWaveShapeTabs(shape, 114, accent);
}

void drawOscillatorParameterEdit(uint16_t accent) {
  int oscillator = getCurrentWaveVoiceIndex();
  int itemIndex = getMenuItemIndex(selectedItem);
  const char* value = getValueText(itemIndex);

  drawValueReadout(value, menuItems[itemIndex].tag, accent);
  char oscillatorText[12];
  snprintf(oscillatorText,
           sizeof(oscillatorText),
           "OSC%d %s",
           oscillator + 1,
           oscillatorEnabled[oscillator] ? "ON" : "OFF");
  printRight(oscillatorText,
             150,
             67,
             1,
             oscillatorEnabled[oscillator] ? getMixerVoiceColor(oscillator, accent)
                                           : COL_MUTED);
  drawVoiceScopePanel(oscillator, accent);

  tft.setTextSize(1);
  tft.setTextColor(COL_MUTED);
  tft.setCursor(11, 120);
  tft.print(getWaveformShortName(waveVoiceShape[oscillator]));
  char levelText[12];
  snprintf(levelText, sizeof(levelText), "LEVEL %d", waveVoiceLevels[oscillator]);
  printRight(levelText,
             149,
             120,
             1,
             waveVoiceLevels[oscillator] > 0 ? COL_GOLD : COL_MUTED);
}

void drawVoiceTuneEdit(uint16_t accent) {
  int voice = getCurrentWaveVoiceIndex();
  char value[12];
  snprintf(value, sizeof(value), "%+dst", waveVoiceTune[voice]);

  drawValueReadout(value, "TUNE", accent);
  printRight(waveformNames[waveVoiceShape[voice]], 150, 67, 1, getMixerVoiceColor(voice, accent));
  drawVoiceScopePanel(voice, accent);

  tft.setTextSize(1);
  tft.setTextColor(COL_MUTED);
  tft.setCursor(10, 112);
  tft.print("-48");
  printRight("+48", 150, 112, 1, COL_MUTED);
  drawGrooveBar(50, 115, 60, 8, map(waveVoiceTune[voice], -48, 48, 0, 58), accent);
}

void drawVoiceFoldEdit(uint16_t accent) {
  int voice = getCurrentWaveVoiceIndex();
  char value[12];
  int driveTenths = 10 + (waveVoiceFold[voice] * 24) / 100;
  snprintf(value, sizeof(value), "%d%%", waveVoiceFold[voice]);

  drawValueReadout(value, "FOLD", accent);
  char driveText[16];
  snprintf(driveText, sizeof(driveText), "x%d.%d", driveTenths / 10, driveTenths % 10);
  printRight(driveText, 150, 67, 1, COL_INK);
  drawVoiceScopePanel(voice, accent);

  tft.setTextSize(1);
  tft.setTextColor(COL_MUTED);
  tft.setCursor(10, 112);
  tft.print("CLEAN");
  printRight("FOLD", 150, 112, 1, COL_MUTED);
  drawGrooveBar(50, 115, 60, 8, map(waveVoiceFold[voice], 0, 100, 0, 58), accent);
}

void drawVoiceDetuneEdit(uint16_t accent) {
  int voice = getCurrentWaveVoiceIndex();
  char value[12];
  snprintf(value, sizeof(value), "%+dct", waveVoiceDetune[voice]);

  drawValueReadout(value, "DETUNE", accent);

  printRight(waveVoiceDetune[voice] == 0 ? "CENTER" : waveVoiceDetune[voice] > 0 ? "SHARP" : "FLAT",
             150, 67, 1, COL_INK);
  drawVoiceScopePanel(voice, accent);

  tft.setTextSize(1);
  tft.setTextColor(COL_MUTED);
  tft.setCursor(10, 112);
  tft.print("FLAT");
  printRight("SHARP", 150, 112, 1, COL_MUTED);
  drawGrooveBar(50, 115, 60, 8, map(waveVoiceDetune[voice], -100, 100, 0, 58), accent);
}

void drawVoiceScopeEdit(uint16_t accent) {
  int voice = getCurrentWaveVoiceIndex();
  drawValueReadout("LIVE", "SCOPE", accent);
  printRight(waveformNames[waveVoiceShape[voice]], 150, 67, 1, getMixerVoiceColor(voice, accent));
  drawVoiceScopePanel(voice, accent);

  tft.setTextSize(1);
  tft.setTextColor(COL_MUTED);
  tft.setCursor(11, 120);
  tft.print("T");
  tft.print(waveVoiceTune[voice]);
  tft.print(" F");
  tft.print(waveVoiceFold[voice]);
  printRight(waveVoiceLevels[voice] > 0 ? "MIX" : "MUTE", 149, 120, 1, waveVoiceLevels[voice] > 0 ? COL_GOLD : COL_MUTED);
}

int getFilterCutoffMarkerX(int x, int width) {
  float minHz = (float)FILTER_MIN_CUTOFF_HZ;
  float maxHz = (float)FILTER_MAX_CUTOFF_HZ;
  float cutoff = clampFloat((float)filterCutoff, minHz, maxHz);
  float position = logf(cutoff / minHz) / logf(maxHz / minHz);

  return x + clampInt((int)(position * (width - 1)), 0, width - 1);
}

void drawFilterCurve(uint16_t accent) {
  int x = 10;
  int y = 74;
  int width = 140;
  int height = 42;
  int plotX = x + 8;
  int plotY = y + 6;
  int plotW = width - 16;
  int plotH = height - 13;
  int lowY = plotY + plotH - 2;
  int highY = plotY + 2;
  int midY = plotY + plotH / 2;
  int cutX = getFilterCutoffMarkerX(plotX, plotW);
  uint16_t curveColor = filterEnabled ? accent : rgb565(62, 68, 82);

  drawPanelFrame(x, y, width, height, accent);
  drawScopeGrid(x, y, width, height);
  tft.drawFastHLine(plotX, lowY, plotW, rgb565(34, 40, 53));
  tft.drawFastVLine(plotX, highY, plotH, rgb565(34, 40, 53));

  if (filterType == 1) {
    int kneeX = min(plotX + plotW - 1, cutX + 18);
    tft.drawLine(plotX, lowY, cutX, lowY, curveColor);
    tft.drawLine(cutX, lowY, kneeX, highY, curveColor);
    tft.drawLine(kneeX, highY, plotX + plotW - 1, highY, curveColor);
  } else if (filterType == 2) {
    int leftX = max(plotX, cutX - 28);
    int rightX = min(plotX + plotW - 1, cutX + 28);
    tft.drawLine(plotX, lowY, leftX, lowY, curveColor);
    tft.drawLine(leftX, lowY, cutX, highY, curveColor);
    tft.drawLine(cutX, highY, rightX, lowY, curveColor);
    tft.drawLine(rightX, lowY, plotX + plotW - 1, lowY, curveColor);
  } else {
    int kneeX = min(plotX + plotW - 1, cutX + 18);
    tft.drawLine(plotX, highY, cutX, highY, curveColor);
    tft.drawLine(cutX, highY, kneeX, lowY, curveColor);
    tft.drawLine(kneeX, lowY, plotX + plotW - 1, lowY, curveColor);
  }

  tft.drawFastVLine(cutX, plotY, plotH, COL_GOLD);
  tft.fillCircle(cutX, filterType == 2 ? highY : midY, 2, COL_GOLD);
}

void drawFilterPowerEdit(uint16_t accent) {
  drawValueReadout(filterEnabled ? "ON" : "OFF", "FILTER", accent);
  printRight(FILTER_TYPE_NAMES[filterType], 150, 67, 1, filterEnabled ? COL_GOLD : COL_MUTED);
  drawFilterCurve(accent);
  printRight(filterEnabled ? "active" : "bypass", 149, 120, 1, filterEnabled ? COL_GOLD : COL_MUTED);
}

void drawFilterTypeEdit(uint16_t accent) {
  drawValueReadout(FILTER_TYPE_NAMES[filterType], "TYPE", accent);
  printRight(filterEnabled ? "active" : "bypass", 150, 67, 1, filterEnabled ? COL_GOLD : COL_MUTED);
  drawFilterCurve(accent);
  printRight("LP HP BP", 149, 120, 1, COL_MUTED);
}

void drawFilterCutoffEdit(uint16_t accent) {
  char cutoffText[14];
  snprintf(cutoffText, sizeof(cutoffText), "%dHz", filterCutoff);

  drawValueReadout(cutoffText, "CUTOFF", accent);
  printRight(FILTER_TYPE_NAMES[filterType], 150, 67, 1, filterEnabled ? COL_GOLD : COL_INK);
  drawFilterCurve(accent);

  int fill = map(filterCutoff, FILTER_MIN_CUTOFF_HZ, FILTER_MAX_CUTOFF_HZ, 0, 58);
  drawGrooveBar(50, 116, 60, 8, fill, accent);
  tft.setTextSize(1);
  tft.setTextColor(COL_MUTED);
  tft.setCursor(10, 116);
  tft.print("40");
  printRight("12K", 150, 116, 1, COL_MUTED);
}

void drawAdsrEdit(uint16_t accent) {
  drawValueReadout("VIEW", "ADSR", accent);
  printRight("overview", 150, 67, 1, COL_INK);
  drawAdsrCurve(accent);
}

void drawAttackEdit(uint16_t accent) {
  drawValueReadout(getValueText(getMenuItemIndex(selectedItem)), activeEnvelopeIndex == ENVELOPE_ENV2 ? "ENV2 A" : "ENV1 A", accent);
  printRight("attack", 150, 67, 1, COL_INK);
  drawAdsrCurve(accent);
}

void drawDecayEdit(uint16_t accent) {
  drawValueReadout(getValueText(getMenuItemIndex(selectedItem)), activeEnvelopeIndex == ENVELOPE_ENV2 ? "ENV2 D" : "ENV1 D", accent);
  printRight("decay", 150, 67, 1, COL_INK);
  drawAdsrCurve(accent);
}

void drawSustainEdit(uint16_t accent) {
  drawValueReadout(getValueText(getMenuItemIndex(selectedItem)), activeEnvelopeIndex == ENVELOPE_ENV2 ? "ENV2 S" : "ENV1 S", accent);
  printRight("sustain", 150, 67, 1, COL_INK);
  drawAdsrCurve(accent);
}

void drawReleaseEdit(uint16_t accent) {
  drawValueReadout(getValueText(getMenuItemIndex(selectedItem)), activeEnvelopeIndex == ENVELOPE_ENV2 ? "ENV2 R" : "ENV1 R", accent);
  printRight("release", 150, 67, 1, COL_INK);
  drawAdsrCurve(accent);
}

void drawModulationRouteEdit(uint16_t accent) {
  const ModRouteSettings& route = getActiveModulationRoute();
  const ModDestinationInfo& destination = MOD_DESTINATIONS[activeModDestinationIndex];
  MenuAction action = getSelectedAction();

  drawValueReadout(getValueText(getMenuItemIndex(selectedItem)),
                   action == ACTION_MOD_ROUTE_ENABLED ? "ENABLED" : "AMOUNT",
                   route.enabled ? accent : COL_MUTED);
  printRight(destination.tag, 150, 67, 1, COL_INK);
  drawPanelFrame(10, 78, 140, 35, accent);

  int centerX = 80;
  int amountX = centerX + map((int)route.amountPercent, -100, 100, -58, 58);
  tft.drawFastHLine(20, 94, 120, COL_LINE);
  tft.drawFastVLine(centerX, 86, 17, COL_INK);
  int left = min(centerX, amountX);
  int width = abs(amountX - centerX);
  if (width > 0) tft.fillRect(left, 90, width, 9, route.enabled ? accent : COL_MUTED);

  tft.setTextSize(1);
  tft.setTextColor(COL_MUTED);
  tft.setCursor(10, 119);
  tft.print("-100");
  printRight("+100", 150, 119, 1, COL_MUTED);
}

void drawScopeEdit(uint16_t accent) {
  drawValueReadout("LIVE", "SCOPE", accent);
  drawPanelFrame(10, 74, 140, 42, accent);
  drawScopeGrid(10, 74, 140, 42);
  drawOscilloscopeTrace(14, 79, 132, 33, accent, true);

  tft.setTextSize(1);
  tft.setTextColor(COL_MUTED);
  tft.setCursor(11, 120);
  tft.print(waveformNames[waveform]);
  tft.print(" ");
  tft.print(volume);
  tft.print("%");
}

void drawAudioTestEdit(uint16_t accent) {
  drawValueReadout("SINE", "TEST", accent);
  printRight("DAISY OUT", 150, 67, 1, COL_INK);

  drawPanelFrame(10, 74, 140, 42, accent);
  drawScopeGrid(10, 74, 140, 42);
  drawWaveShapePreviewForParams(14, 79, 132, 33, 0, 0.0f, 0.0f, accent);

  tft.setTextSize(1);
  tft.setTextColor(COL_MUTED);
  tft.setCursor(11, 120);
  tft.print(AUDIO_TEST_FREQUENCY_HZ);
  tft.print("Hz fixed");
  bool audioReady = DaisyBridge::isConnected();
  printRight(audioReady ? "LINK ON" : "LINK WAIT", 149, 120, 1,
             audioReady ? COL_GOLD : COL_MUTED);
}

uint16_t getSequencerTrackColor(int track) {
  switch (clampInt(track, 0, SEQUENCER_TRACK_COUNT - 1)) {
    case SEQUENCER_TRACK_VOICE_1: return COL_CORAL;
    case SEQUENCER_TRACK_VOICE_2: return COL_SKY;
    default: return COL_NOTE;
  }
}

bool isSequencerTrackStepEnabled(int track, int step) {
  if (step < 0 || step >= SEQUENCER_STEP_COUNT) return false;
  track = clampInt(track, 0, SEQUENCER_TRACK_COUNT - 1);
  if (track == SEQUENCER_TRACK_KICK) return kickStepEnabled[step];
  return sequencerStepEnabled[track][step];
}
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
