polyrhythmic-glider/hardware-toolkit/TheSynthProject/UiScreens.h

#pragma once

// =======================
// BOOT / PREMENU DRAW
// =======================

void drawBootScreen() {
  uint32_t elapsed = millis() - bootStartMs;
  int progress = bootReady ? 100 : clampInt((int)((elapsed * 100) / bootDurationMs), 0, 100);

  if (fullRedraw || lastDrawnMode != MODE_BOOT) {
    tft.fillScreen(COL_BG);

    tft.drawFastHLine(10, 19, 140, COL_LINE);
    tft.drawFastHLine(10, 101, 140, COL_LINE);

    tft.setTextColor(COL_NOTE);
    tft.setTextSize(2);
    tft.setCursor(8, 30);
    tft.print("Polyrhythmic");

    tft.setTextColor(COL_GOLD);
    tft.setCursor(45, 52);
    tft.print("Glider");

    tft.setTextSize(1);
    tft.setTextColor(COL_MUTED);
    tft.setCursor(12, 78);
    tft.print("made with love and weed");

    tft.drawRect(18, 108, 124, 8, COL_LINE);

    lastBootProgress = -1;
    lastDrawnMode = MODE_BOOT;
    fullRedraw = false;
  }

  if (progress != lastBootProgress) {
    int fillW = map(progress, 0, 100, 0, 122);

    tft.fillRect(19, 109, 122, 6, COL_PANEL);
    if (fillW > 0) {
      tft.fillRect(19, 109, fillW, 6, COL_NOTE);
    }

    lastBootProgress = progress;
  }
  tft.fillRect(0, 119, SCREEN_W, 9, COL_BG);
  if (!DaisyBridge::isConnected()) {
    tft.setTextSize(1);
    tft.setTextColor(COL_CORAL);
    tft.setCursor(30, 120);
    tft.print("waiting daisy :)");
  }
}

void drawPreMenuBase() {
  if (TYPE_COUNT <= VISIBLE_TYPE_ROWS) topType = 0;

  drawStageBackdrop();

  drawHeader("SELECT AREA");

  lastSelectedType = -1;
  lastTopType = -1;
}
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
