polyrhythmic-glider/hardware-toolkit/(commit log)

2026-06-15 feat: encoders init
2026-06-15 fix: git repo change
    [AppConfig.h, Hardware.h, Pong.cpp, Pong.h, Render.cpp, Ui.cpp, Ui.h]
2026-06-16 fix: remove pong field dividers in wide mode
    [Render.cpp]
2026-06-16 feat: add scrollable test mode and clean encoder UI
2026-07-16 feat: commit pigro
    [partitions.csv]
2026-07-20 Integrate hardware control surface and reorganize firmware
    Major refactoring to consolidate firmware and integrate the 4-encoder control surface:
    - Renamed testLCD → TheSynthProject as primary firmware
    - Added ControlSurface namespace with full OLED/encoder management on separate I2C bus (MCP23017)
    - Reorganized repository: examples-and-tests now contains legacy builds and hardware tests
    - Expanded sequencer from 8 to 16 steps with NeoKey support (4×1x4 boards)
    - Enhanced audio engine with shape crossfading and step edge fading
    - Improved diagnostics: separate debug panels for OLED and MCP23017 buses
    - Updated pin naming to match physical ESP32 labels (D21, D15, etc.)
    - Added preset migr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
    [partitions.csv]
2026-07-29 Native audio engine, sequencer simplification
    Replace legacy audio path with a native ESP32 render task and improved DSP: add I2S DMA buffer settings, audio memory logging, block-parameter smoothing, fast sine lookup table, stable delay/reverb handling and DSP recovery, direct 440Hz I2S test, realtime rendering metrics and safer I2S write handling. Simplify sequencer to a forward-only minimal clock (remove direction/gate/transpose/step-shape and pattern utilities) and keep clock running even when silent. Remove FFT/spectrum analysis and UI items. Update menus, widgets, and control-surface bindings accordingly. Change NeoKey wiring/addresses (0x30..0x33), key mapping, debounce and LED update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
    [AppControl.h, AppLifecycle.h, ControlSurfaceBridgeImpl.h, MenuModel.h, NeoKeySequencerPanel.h, PresetStore.h, SequencerModel.h, SignalAnalysis.h]
2026-07-29 Add SH1106 support and mixed OLED driver
    Introduce MixedOledDisplay to support both SSD1306 and SH1106 controllers while keeping the Adafruit_GFX framebuffer. Add OledController enum and controllerForChannel/controllerName helpers. Use SURFACE_OLED_SH1106_MASK in HardwarePins.h to mark channels using SH1106 (default 0x07). Update OLED init/display selection and diagnostics to handle SH1106 page-addressing and column offset. Update WIRING_INTEGRATED.md to document the 3x SH1106 + 1x SSD1306 setup and the configuration mask.
2026-08-04 feat(daisy): add UART-controlled audio engine
2026-08-04 fix(sequencer): show kick in combined NeoKey view
    [NeoKeySequencerPanel.h]
2026-08-04 docs(hardware): document Daisy wiring and PCM removal
2026-08-04 fix(daisy): preserve dry kick level
    [DaisySynth.cpp]
2026-08-04 feat(dsp): add fixed-size polyphonic voice engine
    [DaisyLinkProtocol.h, DaisySynth.cpp, SynthEngine.cpp, SynthEngine.h]
2026-09-26 fix(boot): keep pairing notice in loader
    [UiScreens.h]
2026-09-26 fix(debug): pause live monitor after stable pairing
    [AppControl.h, AppLifecycle.h, TheSynthProject.ino]
2026-09-26 fix(synth): disable secondary oscillators by default
    [PresetStore.h, TheSynthProject.ino]
2026-10-22 feat(firmware)!: persist and transmit independent oscillator banks
    BREAKING CHANGE: UART v5 requires updating both ESP32 and Daisy firmware.
    [AppControl.h, DaisyBridge.h, DaisyLinkHostTest.cpp, DaisyLinkProtocol.h, DaisySynth.cpp, OscillatorModel.h, PresetStore.h, SynthRuntime.h]
